Miceuz/radiobus/(threads)

Thread 1 (2021-07-01):

Firmware compilation: TypeError

blizzard4591, 2021-07-01:
Hi,
I have a "Low power LoRa I2C & RS485 node (868MHz)" and am trying to compile the example firmware.
I tested using Win10 + VSCode as well as Ubuntu 20LTS + VSCode. In both instances and for both "LoraNodeProto1" and "SHT25", I checked out the code from git and did a "pio run -t build" in the terminal of VSCode.

In all cases, I end up with the same error message:
```
PS P:\Dev\LoRaNode-radiobus\Firmware\SHT25> pio run -t build
Processing radiobus (platform: https://github.com/Miceuz/platform-atmelsam; board: radio-bus; framework: arduino)
--------------------------------------------------------------------------------------------------------------------------------------------------------------------------------------------------------------------------------------------------------------------------------------------------------------Tool Manager: Installing git+https://github.com/Miceuz/tool-bossac-catnip
git version 2.29.2.windows.3
Cloning into 'C:\Users\user\.platformio\.cache\tmp\pkg-installing-5ohvjflf'...
remote: Enumerating objects: 4, done.
remote: Counting objects: 100% (4/4), done.
remote: Compressing objects: 100% (4/4), done.
remote: Total 4 (delta 0), reused 4 (delta 0), pack-reused 0
Receiving objects: 100% (4/4), 415.80 KiB | 6.40 MiB/s, done.
Tool Manager: tool-bossac @ 1.19200.0+sha.1dcff71 has been installed!
Verbose mode can be enabled via `-v, --verbose` option
CONFIGURATION: https://docs.platformio.org/page/boards/atmelsam/radio-bus.html
PLATFORM: Atmel SAM (4.4.0+sha.01698f8) > Radio Bus V1
HARDWARE: SAMR34J18B 48MHz, 39.06KB RAM, 250KB Flash
DEBUG: Current (blackmagic) External (blackmagic)
PACKAGES:
 - framework-arduino-samr-catnip 1.0.0+sha.f3dc4bf
 - framework-cmsis 1.40500.0 (4.5.0)
 - framework-cmsis-atmel 1.2.2
 - toolchain-gccarmnoneeabi 1.70201.0 (7.2.1)
TypeError: stat: path should be string, bytes, os.PathLike or integer, not NoneType:
  File "C:\Users\user\.platformio\penv\Lib\site-packages\platformio\builder\main.py", line 177:
    env.SConscript("$BUILD_SCRIPT")
  File "C:\Users\user\.platformio\packages\tool-scons\scons-local-4.1.0\SCons\Script\SConscript.py", line 591:
    return _SConscript(self.fs, *files, **subst_kw)
  File "C:\Users\user\.platformio\packages\tool-scons\scons-local-4.1.0\SCons\Script\SConscript.py", line 280:
    exec(compile(scriptdata, scriptname, 'exec'), call_stack[-1].globals)
  File "C:\Users\user\.platformio\platforms\atmelsam\builder\main.py", line 127:
    target_elf = env.BuildProgram()
  File "C:\Users\user\.platformio\packages\tool-scons\scons-local-4.1.0\SCons\Util.py", line 658:
    return self.method(*nargs, **kwargs)
  File "C:\Users\user\.platformio\penv\Lib\site-packages\platformio\builder\tools\platformio.py", line 61:
    env.ProcessProgramDeps()
  File "C:\Users\user\.platformio\packages\tool-scons\scons-local-4.1.0\SCons\Util.py", line 658:
    return self.method(*nargs, **kwargs)
  File "C:\Users\user\.platformio\penv\Lib\site-packages\platformio\builder\tools\platformio.py", line 127:
    env.BuildFrameworks(env.get("PIOFRAMEWORK"))
  File "C:\Users\user\.platformio\packages\tool-scons\scons-local-4.1.0\SCons\Util.py", line 658:
    return self.method(*nargs, **kwargs)
  File "C:\Users\user\.platformio\penv\Lib\site-packages\platformio\builder\tools\platformio.py", line 342:
    SConscript(env.GetFrameworkScript(f), exports="env")
  File "C:\Users\user\.platformio\packages\tool-scons\scons-local-4.1.0\SCons\Script\SConscript.py", line 654:
    return method(*args, **kw)
  File "C:\Users\user\.platformio\packages\tool-scons\scons-local-4.1.0\SCons\Script\SConscript.py", line 591:
    return _SConscript(self.fs, *files, **subst_kw)
  File "C:\Users\user\.platformio\packages\tool-scons\scons-local-4.1.0\SCons\Script\SConscript.py", line 280:
    exec(compile(scriptdata, scriptname, 'exec'), call_stack[-1].globals)
  File "C:\Users\user\.platformio\platforms\atmelsam\builder\frameworks\arduino.py", line 42:
    env.SConscript(os.path.join("arduino", "arduino-%s.py" % MCU_FAMILY))
  File "C:\Users\user\.platformio\packages\tool-scons\scons-local-4.1.0\SCons\Script\SConscript.py", line 591:
    return _SConscript(self.fs, *files, **subst_kw)
  File "C:\Users\user\.platformio\packages\tool-scons\scons-local-4.1.0\SCons\Script\SConscript.py", line 280:
    exec(compile(scriptdata, scriptname, 'exec'), call_stack[-1].globals)
  File "C:\Users\user\.platformio\platforms\atmelsam\builder\frameworks\arduino\arduino-samr.py", line 42:
    assert all(os.path.isdir(d) for d in (FRAMEWORK_DIR, CMSIS_DIR, CMSIS_ATMEL_DIR))
  File "C:\Users\user\.platformio\platforms\atmelsam\builder\frameworks\arduino\arduino-samr.py", line 42:
    assert all(os.path.isdir(d) for d in (FRAMEWORK_DIR, CMSIS_DIR, CMSIS_ATMEL_DIR))
  File "C:\Users\user\.platformio\python3\lib\genericpath.py", line 42:
    st = os.stat(s)
========================================================================================================================================= [FAILED] Took 2.14 seconds =========================================================================================================================================
```

I have no idea what I might be doing wrong.
Could you confirm that this work with default VSCode + PlatformIO and a clean checkout of "https://github.com/Miceuz/radiobus"?

Thank you!

blizzard4591, 2021-07-02:
Okay, got it: The issue is that
```
framework-cmsis-microchip-samr34@https://github.com/Miceuz/framework-cmsis-microchip-samr34
```
is missing from the platformio.ini file in section `[env:radiobus]`. With that, it works.

Closed 2021-07-08.
