Miceuz/radiobus/simulation/pdn/C1608X5R1C475K080AE.pdf

# C1608X5R1C475K080AE

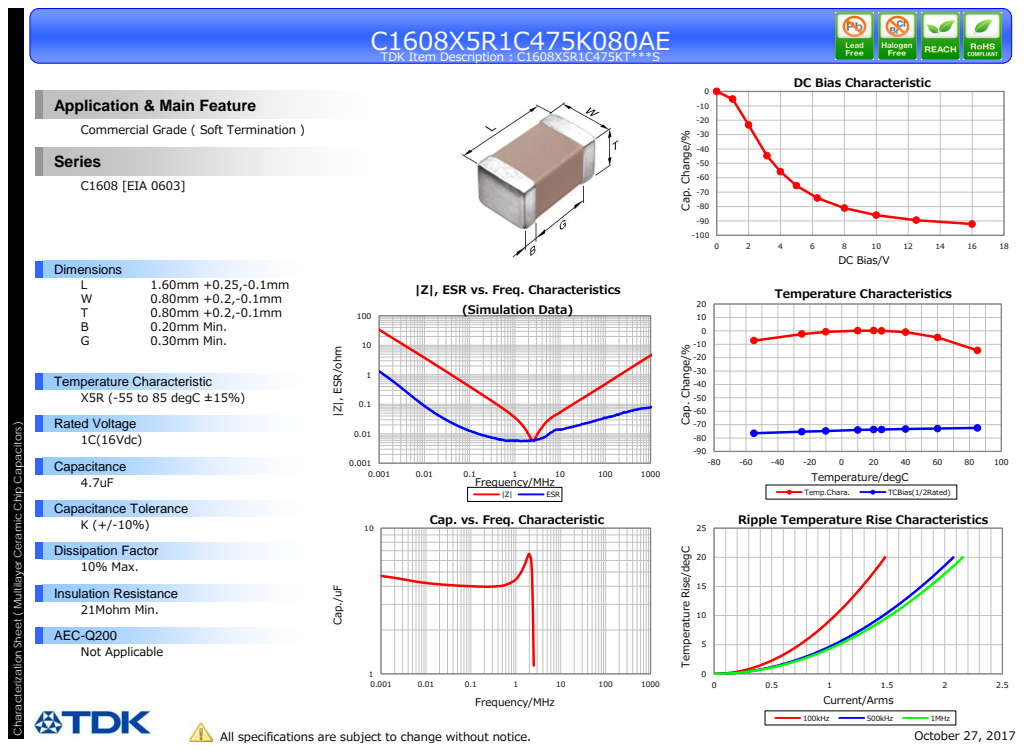
[picture p3: page 1]
0.20mm Min.; 0.30mm Min.; X5R (-55 to 85 degC ±15%); 1C(16Vdc); 10% Max.; 21Mohm Min.; Not Applicable; All specifications are subject to change without notice.; October 27, 2017; Cap./uF; Frequency/MHz; |Z|, ESR/ohm; ESR; Cap. Change/%; DC Bias/V; Temperature/degC; Temperature Characteristics; Temp.Chara.; TCBias(1/2Rated); Current/Arms; 100kHz; 500kHz; 1MHz; Dimensions; Temperature Characteristic; Rated Voltage; Capacitance; Capacitance Tolerance; Dissipation Factor; Insulation Resistance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

TDK Item Description : C1608X5R1C475KT***S

DC Bias Characteristic

Application & Main Feature
Commercial Grade ( Soft Termination )
Series
C1608 [EIA 0603]

Z|, ESR vs. Freq. Characteristics
(Simulation Data)

Characterization Sheet ( Multilayer Ceramic Chip Capacitors )

Cap. vs. Freq. Characteristic

Ripple Temperature Rise Characteristics

Temperature Rise/degC
