Miceuz/radiobus/simulation/pdn/example.asc

C1: cap; 4.05pF
C2: cap; 10µ
L1: ind; 10µ
R1: res; .04
R2: res; 10k
R3: res; 3.8
V1: voltage; ""; AC 1
Named nets: 0
.ac dec 101 1 10g
