Miceuz/radiobus/simulation/pdn/pdn.asc

C1: polcap; 100µ; V=10 Irms=235m Rser=0.46 Lser=0 mfg="Panasonic" pn="ECA1AFQ101" type="Al electrolytic"
I1: current; ""; AC 1; load
L1: ind; 1.6n
L2: ind; 1.5n
L3: ind; 1.6n
L4: ind; 0.5n
L5: ind; 0.5n
L6: ind; 0.5n
L7: ind; 1.6n
L8: ind; 0.5n
L9: ind; 10n
L10: ind; 5n
L11: ind; 1.6n
L12: ind; 0.5n
R1: res; 0
R2: res; .10
R3: res; 0.034
R4: res; 0.03
R5: res; 0
R6: res; .03
U1: CL10A105KA8NNN_Precise_DC0V_25degC_LT
U2: CL10A475KA8NQN_DC0V_25deg
U3: CL10A104KA8NNN_DC0V_25deg
U4: C1608X5R1V475K080AC_b
U5: CL10A105KA8NNN_Precise_DC0V_25degC_LT
V1: voltage; ""; AC 1; Rser=11
Named nets: 0, out
.ac dec 101 1 1000000k
