Miceuz/radiobus/simulation/pdn/pdn2.asc

C1: polcap; 470µ
C2: cap; 4.7µ
C3: cap; 4.7µ; V=6.3 Irms=9.29 Rser=0.00646575 Lser=0 mfg="KEMET" pn="C0603C475K9PAC" type="X5R"
C4: cap; 1µ
C5: cap; 33n
C6: cap; 1µ
C7: cap; 470n
C8: cap; 0.033µ
I1: current; ""; AC 1; load
L1: ind; 1.6n
L2: ind; 1.5n
L3: ind; 1.6n
L4: ind; 0.5n
L5: ind; 0.5n
L6: ind; 0.5n
L7: ind; 1.6n
L8: ind; 0.5n
L9: ind; 10n
L10: ind; 5n
L11: ind; 0.5n
L12: ind; 1.6n
L13: ind; 0.5n
L14: ind; 0.5n
L15: ind; 0.5n
L16: ind; 1.6n
R1: res; 0.01
R2: res; .215
R3: res; 0.01
R4: res; .025
R5: res; .05
R6: res; 1G
R7: res; 0.034
R8: res; .025
R9: res; 0.05
R10: res; .215
V1: voltage; 1; Rser=11
Named nets: 0, out
.ac dec 101 1 1000000k
