Miceuz/radiobus/(commit log)

2020-05-14 Drag over work from Raindrop project, switch to RAK4260 module, route the first board version
    [LoRaNode-B_Cu.gbr, LoRaNode-B_Mask.gbr, LoRaNode-B_Paste.gbr, LoRaNode-B_SilkS.gbr, LoRaNode-Edge_Cuts.gbr, LoRaNode-F_Cu.gbr, LoRaNode-F_Mask.gbr, LoRaNode-F_Paste.gbr]
2020-06-14 Fix a bug with missing GND connection to main regulator. Swap MISO and MOSI pins because that's what we can have from formware point of view
    [LoRaNode.kicad_pcb, LoRaNode.kicad_sch, battery-protection.kicad_sch, i2c-interface.kicad_sch, rs485-interface.kicad_sch, voltage-regulation.kicad_sch]
2020-06-16 Pull in demo LoRa code from Raindrop project, disable sleep until it's solved, add fixes for RAK4260 TXCO and RF switch power switching, add fix for RF switch direction switching to TXSTART and RXSTA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
    [main.cpp, pins.h, radio.cpp, radio.h]
2020-09-22 Ignore more backups and generated bom
2020-09-22 New kicad formats. Mark holes and fiducials and other DNP components as non-bom, update values for transistors and diodes
    [LoRaNode.kicad_sch, battery-protection.kicad_sch, i2c-interface.kicad_sch, rs485-interface.kicad_sch, voltage-regulation.kicad_sch]
2020-09-22 Remove unused components, mark logos as pcb only, update values for transistors and diodes, sync with schematics
    [LoRaNode.kicad_pcb, LoRaNode.kicad_sch]
2020-09-22 Put fab layer to order. Mark smd parts as smd
    [LoRaNode.kicad_pcb]
2020-09-22 Ignore kicad_prl files as they keep view related info
2020-09-30 Fix ADC wakeup bug.
2020-11-19 Put together a demo firmware that sends battery voltage periodically
2020-11-20 Update PCB: * Update shape so it fits into case * Update most of the components for JLCPCB assembly
    [LoRaNode.kicad_pcb, LoRaNode.kicad_sch, battery-protection.kicad_sch, i2c-interface.kicad_sch, rs485-interface.kicad_sch, voltage-regulation.kicad_sch]
2020-11-21 Change i2c TVS to obtainable one
    [LoRaNode.kicad_pcb, LoRaNode.kicad_sch, i2c-interface.kicad_sch]
2021-07-03 Fixed the missing framework-cmsis-microchip-samr34 issue for both firmwares.
2021-07-12 Add a missing file to fw example
    [radio.cpp]
2022-03-11 Switch SF to SF7 as SFB seems to be somewhat problematic
    [radio.cpp]
2022-03-24 Properly wait for LMIC to finish TTN might ask a status from device even in ABP mode, so we wait till tx path is clear. Setup pins to default state before first use, also switch A0 to input before re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
2022-04-29 Fix DEVUI endianness, switch to SF12
    [radio.cpp]
2022-07-30 Implement sleeping during LoRaWAN send
    Reduces power consumption drastically
2022-07-30 Rename the sleep time unit to a more accurate one
    Since we run RTC at 32k, the shortest sleep time is ~30us
    [main.cpp]
2022-09-02 Add us915 compatibility, also set tx power to sane maximum
2022-10-07 Wait for voltage stabilisation more before measuring battery level
